benhartwich/Grabstein/gehaeuse/vorschau_3d.png

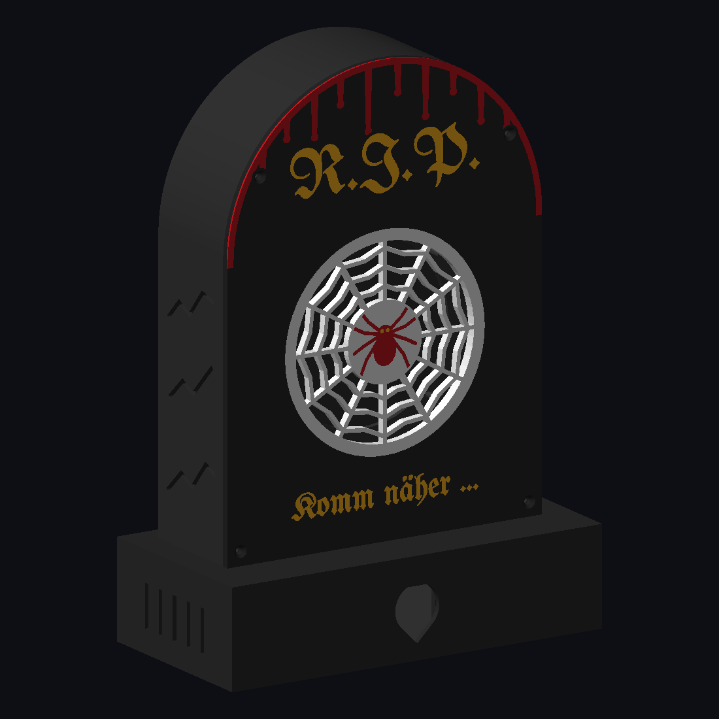
gehaeuse/vorschau_3d.png
