benhartwich/Grabstein/gehaeuse/vorschau_explosion.png

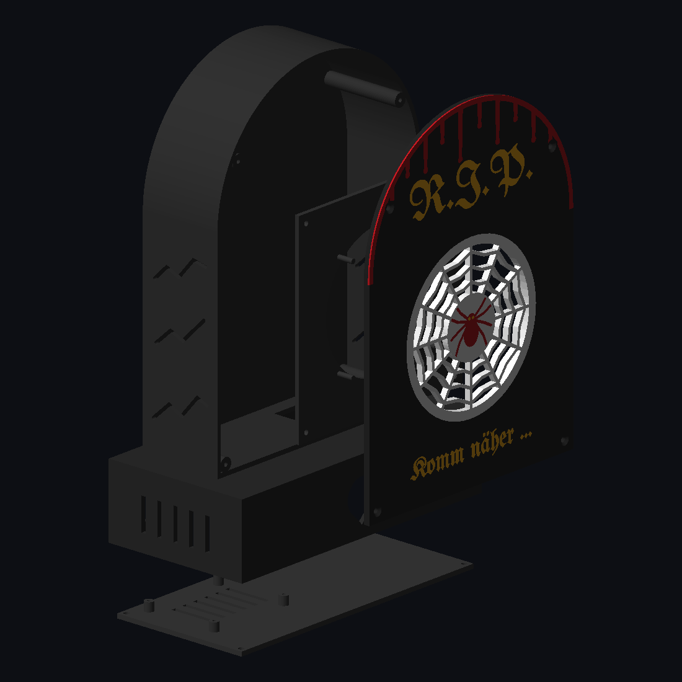
gehaeuse/vorschau_explosion.png
