benhartwich/Grabstein/gehaeuse/druck/Druck_5_Klemmdeckel_Regendach.3mf

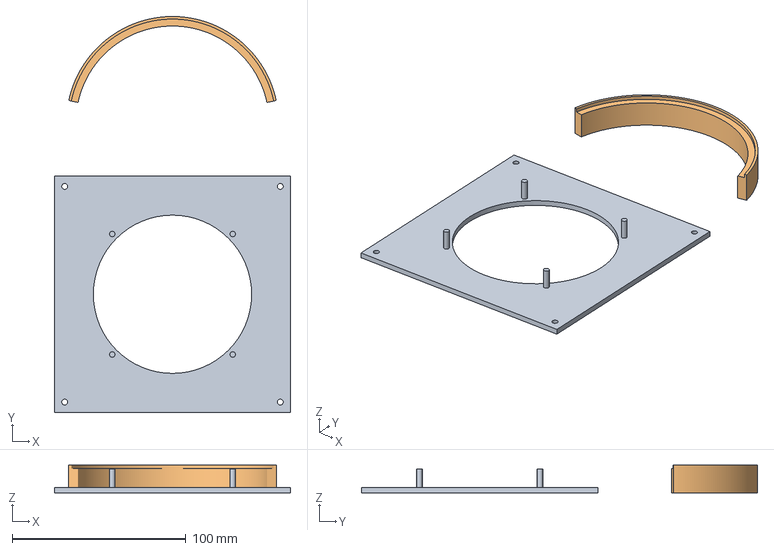
[picture p4: CAD file, 2026-10-17]
gehaeuse/druck/Druck_5_Klemmdeckel_Regendach.3mf
136.0 x 227.7 x 16.0 mm
Klemmdeckel
Regendach
