benhartwich/Grabstein/gehaeuse/stl/4_Bodenplatte_schwarz.stl

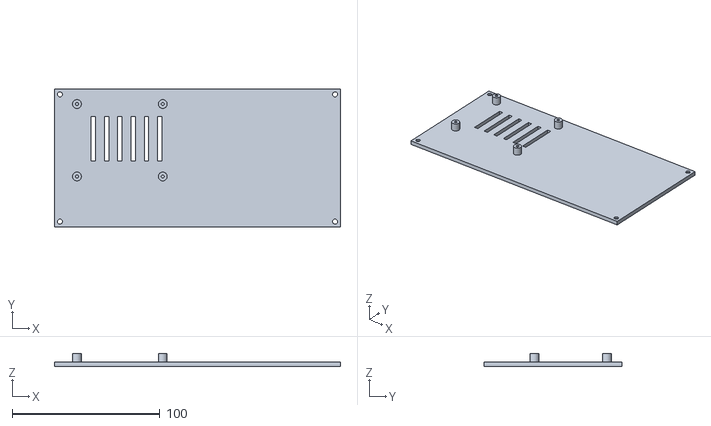
[picture p5: CAD file, 2026-10-16]
gehaeuse/stl/4_Bodenplatte_schwarz.stl
193.4 x 93.4 x 9.00
