benhartwich/Grabstein/gehaeuse/stl/6_Regendach_schwarz.stl

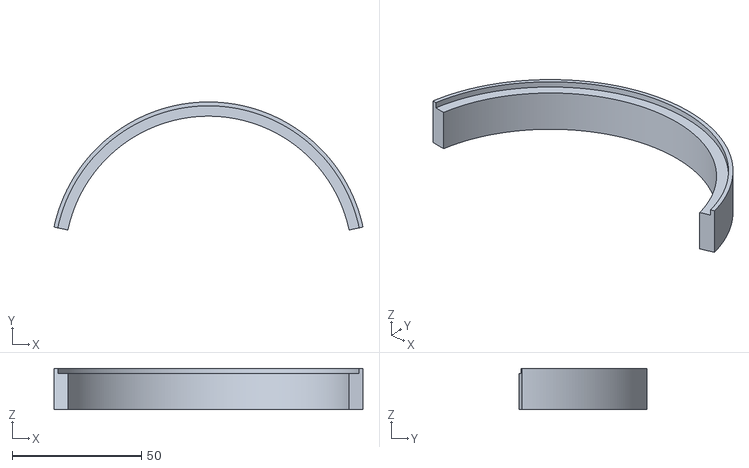
[picture p6: CAD file, 2026-10-16]
gehaeuse/stl/6_Regendach_schwarz.stl
119.3 x 49.5 x 16.0
