benhartwich/Grabstein/gehaeuse/druck/Druck_1_Frontplatte_4Farben.3mf

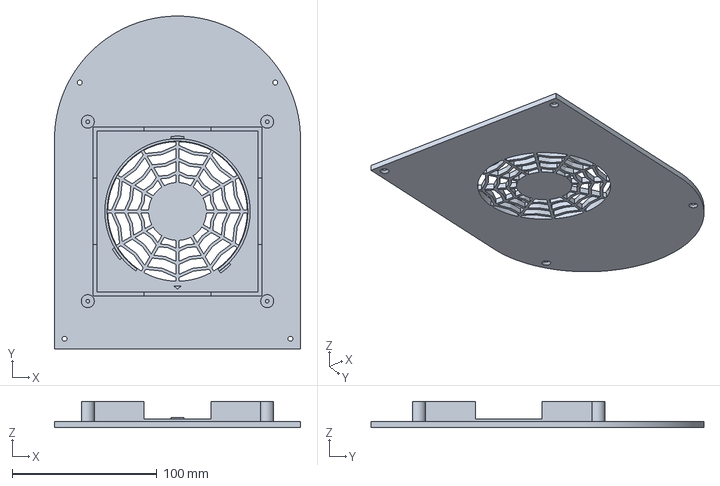
[picture p7: CAD file, 2026-10-16]
gehaeuse/druck/Druck_1_Frontplatte_4Farben.3mf
170.0 x 230.0 x 18.0 mm
