benhartwich/Grabstein/gehaeuse/stl/1_Frontplatte_B_weiss_Netz.stl

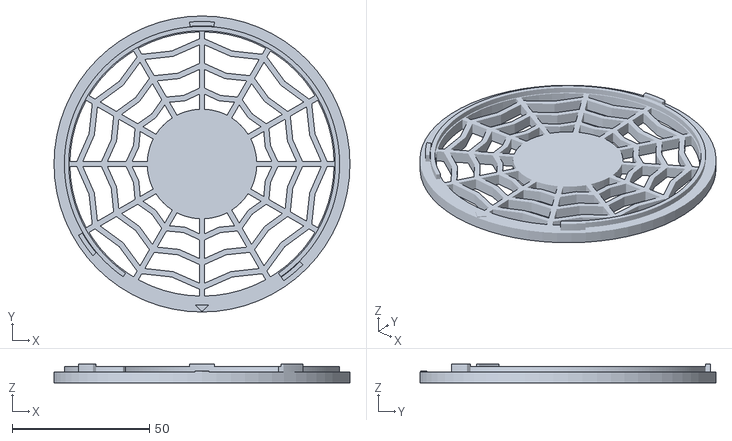
[picture p8: CAD file, 2026-10-16]
gehaeuse/stl/1_Frontplatte_B_weiss_Netz.stl
108.0 x 108.0 x 6.80
