benhartwich/Grabstein/gehaeuse/druck/Druck_2_Korpus.3mf

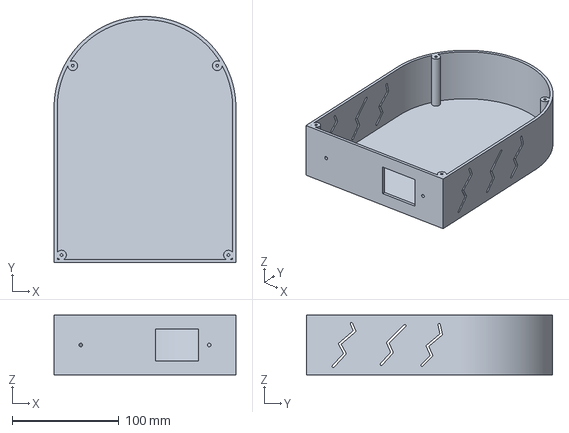
[picture p9: CAD file, 2026-10-16]
gehaeuse/druck/Druck_2_Korpus.3mf
170.0 x 230.0 x 56.0 mm
