benhartwich/Grabstein/gehaeuse/stl/1_Frontplatte_D_leucht_Schrift_Augen.stl

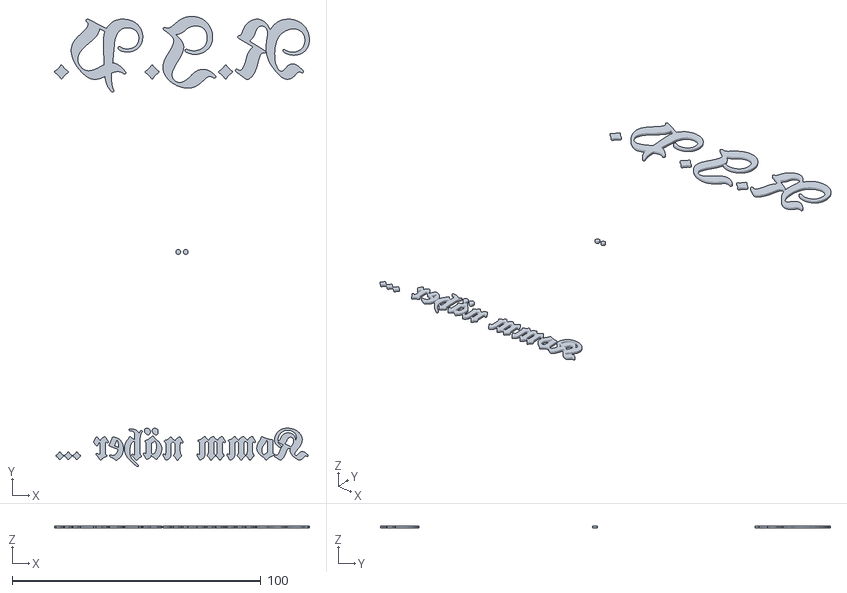
[picture p10: CAD file, 2026-10-16]
gehaeuse/stl/1_Frontplatte_D_leucht_Schrift_Augen.stl
102.5 x 181.0 x 1.00
