benhartwich/Grabstein/gehaeuse/druck/Druck_3_Sockel.3mf

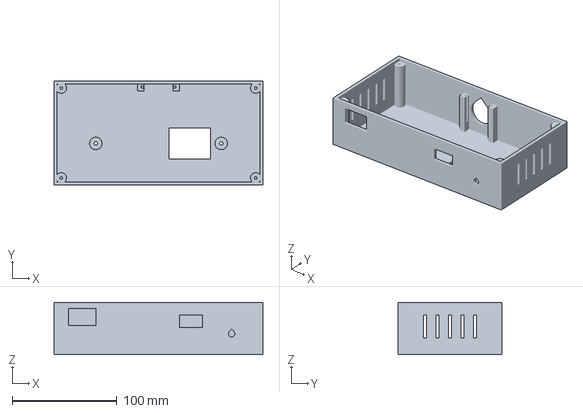
[picture p11: CAD file, 2026-10-16]
gehaeuse/druck/Druck_3_Sockel.3mf
200.0 x 100.0 x 50.0 mm
