benhartwich/Grabstein/gehaeuse/stl/5_Klemmdeckel_schwarz.stl

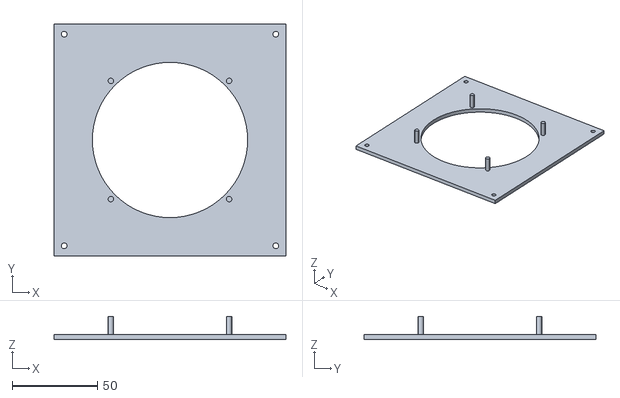
[picture p12: CAD file, 2026-10-16]
gehaeuse/stl/5_Klemmdeckel_schwarz.stl
136.0 x 136.0 x 13.7
