benhartwich/Grabstein/gehaeuse/stl/1_Frontplatte_A_schwarz.stl

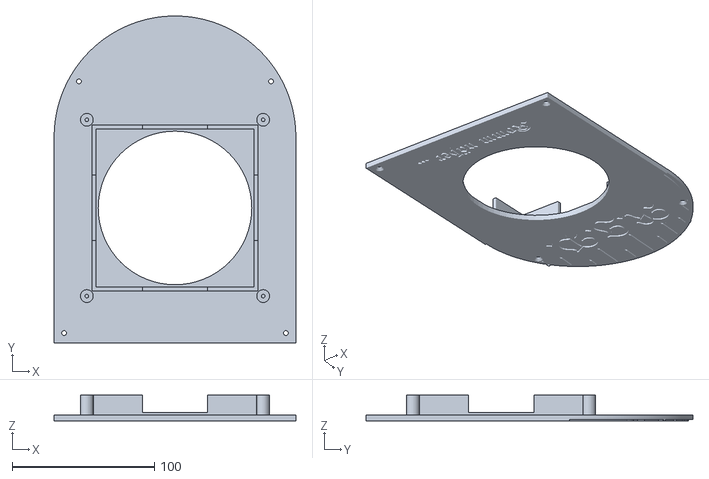
[picture p13: CAD file, 2026-10-16]
gehaeuse/stl/1_Frontplatte_A_schwarz.stl
170.0 x 230.0 x 18.0
