benhartwich/Grabstein/gehaeuse/stl/1_Frontplatte_C_rot_Blut_Spinne.stl

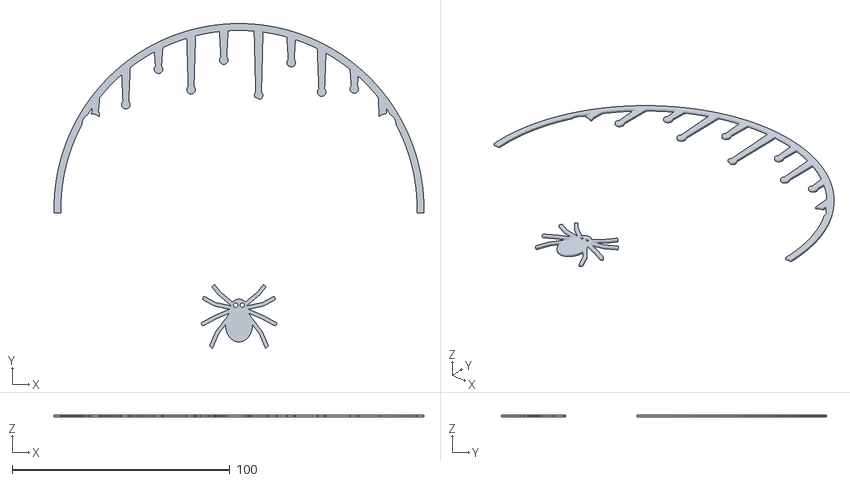
[picture p14: CAD file, 2026-10-16]
gehaeuse/stl/1_Frontplatte_C_rot_Blut_Spinne.stl
170.0 x 149.3 x 1.00
