benhartwich/Grabstein/(list of files, cad)

Other CAD files:
gehaeuse/druck/Druck_4_Bodenplatte.3mf
gehaeuse/stl/3_Sockel_schwarz.stl
gehaeuse/stl/2_Korpus_schwarz.stl
