benhartwich/Grabstein/docs/aufbau-bewegungsmelder.jpg

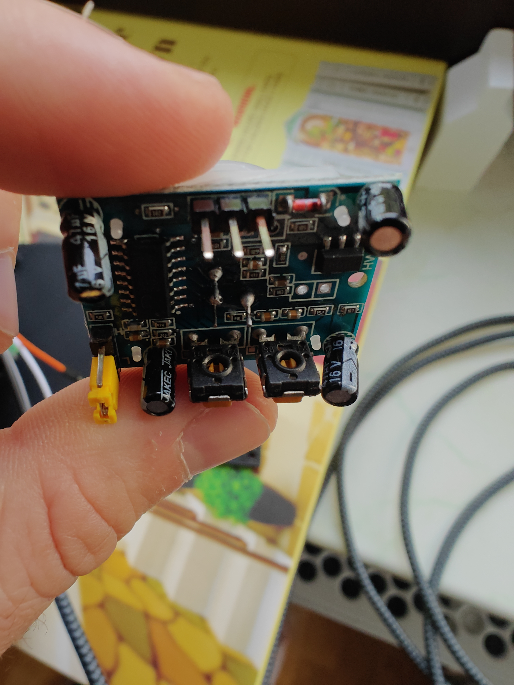
docs/aufbau-bewegungsmelder.jpg
