benhartwich/Grabstein/docs/aufbau-gpio-leiste.jpg

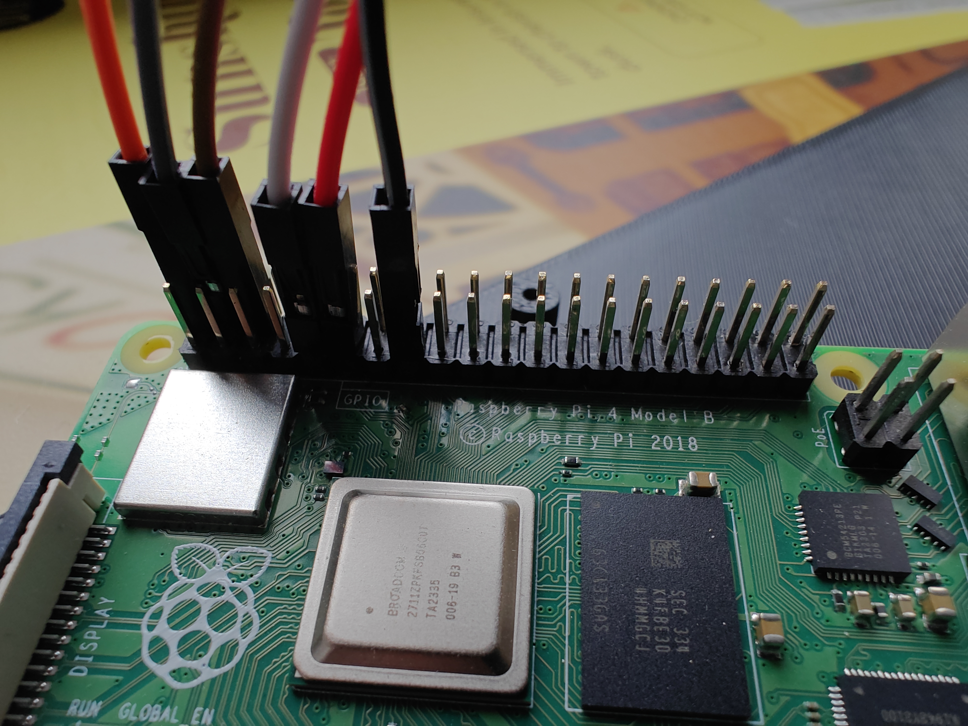
docs/aufbau-gpio-leiste.jpg
