benhartwich/Grabstein/docs/aufbau-pi-oben.jpg

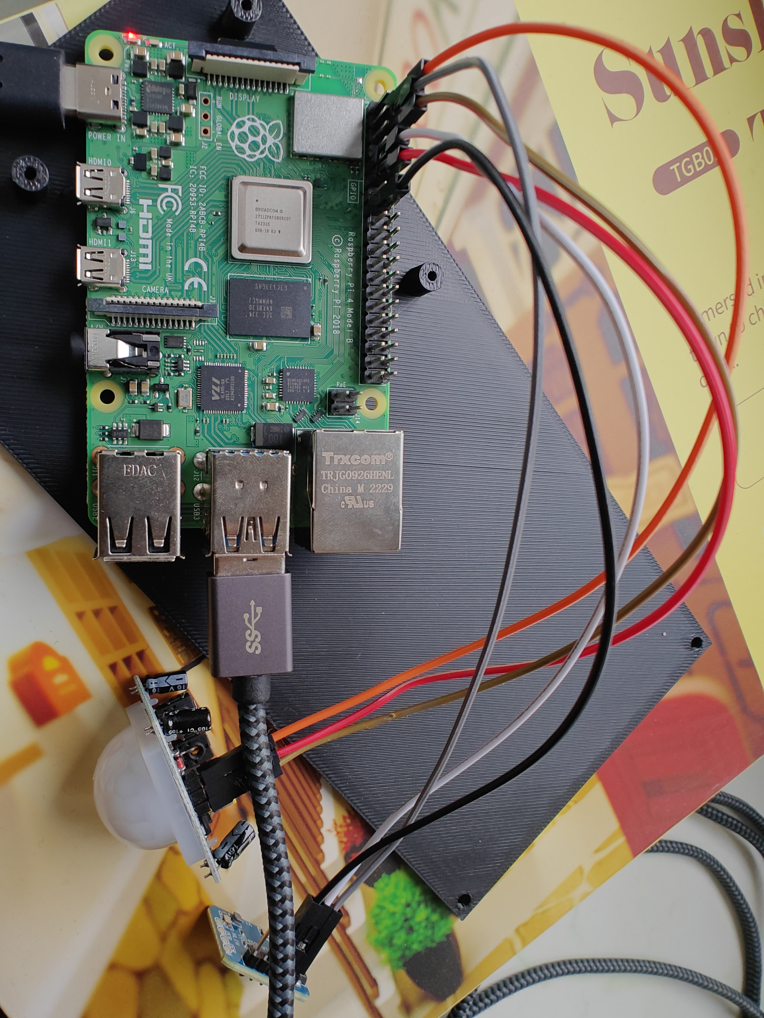
docs/aufbau-pi-oben.jpg
