benhartwich/Grabstein/docs/aufbau-radar-bauteilseite.jpg

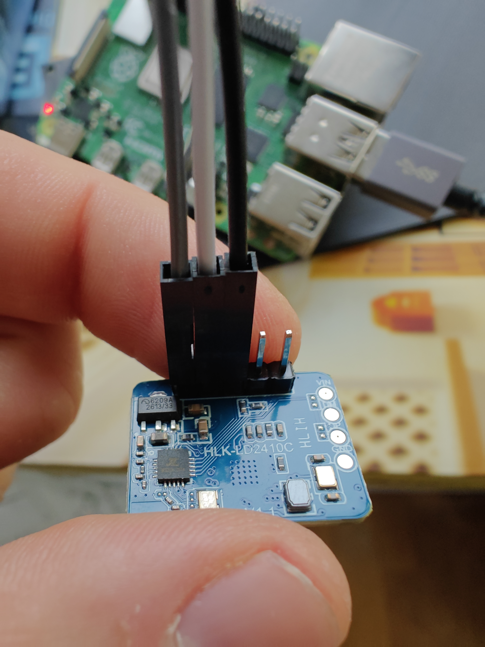
docs/aufbau-radar-bauteilseite.jpg
