benhartwich/Grabstein/docs/aufbau-radar.jpg

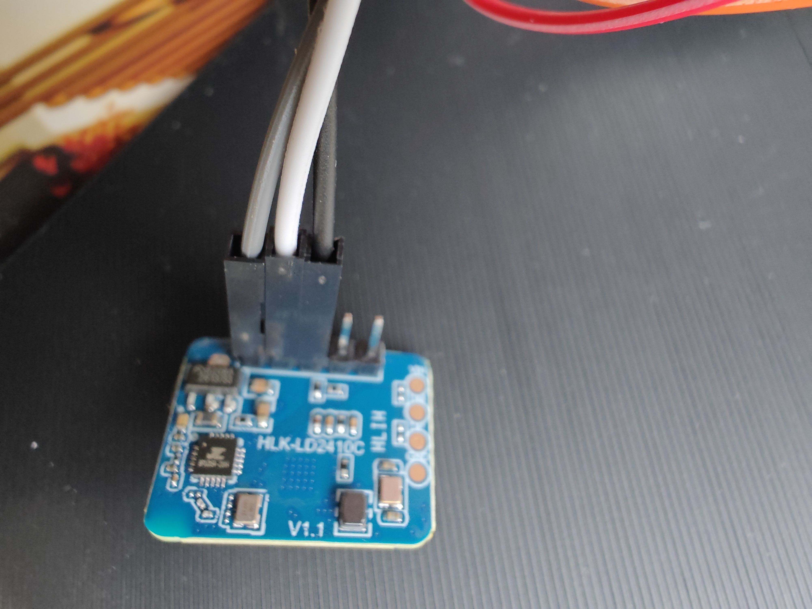
docs/aufbau-radar.jpg
