benhartwich/Grabstein/(commit log)

2026-10-16 Flüsternder Grabstein: Gehäuse, Pi-Software, Verkabelung
    Claude-Session: https://claude.ai/code/session_01KePzFUtdXcww5CumiCLbw3
    [1_Frontplatte_A_schwarz.stl, 1_Frontplatte_B_weiss_Netz.stl, 1_Frontplatte_C_rot_Blut_Spinne.stl, 1_Frontplatte_D_leucht_Schrift_Augen.stl, 2_Korpus_schwarz.stl, 3_Sockel_schwarz.stl, 4_Bodenplatte_schwarz.stl, 5_Klemmdeckel_schwarz.stl]
2026-10-16 Verkabelung: Aktivlautsprecher mit USB-Strom und Klinke
    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
2026-10-16 Verkabelung: passiver Lautsprecher an der JST-Buchse des ReSpeakers
    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
2026-10-17 CLAUDE.md: Kontext und offene Aufgaben für Claude Code auf dem Pi
    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
2026-10-17 install.sh: beschreibbares Arbeitsverzeichnis für lgpio
    Ohne WorkingDirectory läuft der Dienst in /, lgpio kann dort seine
    Notify-Datei nicht anlegen und gpiozero fällt auf den sysfs-Treiber
    zurück, der auf Kernel 6.18 mit EINVAL abbricht.
    Claude-Session: https://claude.ai/code/session_01X3qPP2WJps7P2mzNcSjk38
2026-10-17 Lautstärke 100, set_volume lässt Mikrofonregler in Ruhe
    set_volume setzte jeden Regler nach Namen, damit auch die Mikrofon-
    Verstärkung (Headset) auf die Wiedergabelautstärke, und erwischte den
    zweiten PCM-Regler nicht. Jetzt nur pvolume-Regler, mit Index.
    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
2026-10-17 Web-Oberfläche zum Steuern des Grabsteins
    - web.py + web/: JSON-API und responsive Oberfläche (Start, Zeitplan,
    Clips, Gustav, Mehr), läuft als Thread im Dienst auf Port 80
    - Einstellungen, Zeitplan und Betriebsart in /var/lib/grabstein,
    wirken ohne Neustart; Zeitplan mit Wochentags- und Datums-Einträgen
    - Clip-Katalog mit Bearbeiten, Erzeugen, Hochladen, An/Aus
    - Durchsage mit Gustavs Stimme, Zähler pro Abend
    - Gesprächs-Audio über arecord/aplay: PortAudio hing beim Stoppen, und
    das ReSpeaker-Mikrofon liefert nur bei laufender Wiedergabe (Stille-Strom)
    - Wrapper startet den Dienst nach Tests wieder; grabstein ton hängt nicht mehr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
2026-10-17 Testton leiser und kürzer (1 s, ca. -16 dB statt speaker-test)
    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
2026-10-17 Verkabelung: tatsächlicher Aufbau mit Kabelfarben, Lautsprecher-Einbau
    - verkabelung.html: neuer Abschnitt „So steckt es bei dir“ mit Ansichten
    wie auf den Fotos (Stiftleiste, Radar Bauteilseite, Bewegungsmelder),
    echte Kabelfarben in der Tabelle; Lautsprecher-Abschnitt aus der
    veröffentlichten Version übernommen
    - docs/: Fotos des Aufbaus und LD2410C-Pinbelegung aus dem Datenblatt
    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
2026-10-17 Verkabelung: Bewegungsmelder von der Bauteilseite, Drehregler-Hinweise
    Ansicht wie auf dem Foto (Kuppel hinten, Stifte oben): braun GND, rot OUT,
    orange VCC; VCC an Diode und Regler erkennbar. Fotos in docs/.
    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
2026-10-17 Gustav verabschiedet sich statt abzubrechen, Audio-Tags, neue Begrüßung
    - Am Zeitlimit oder bei leerem Budget bekommt Gustav "ZEIT UM" als
    Kontext-Hinweis, beantwortet das Letzte, verabschiedet sich und legt
    selbst auf; nach 30 s wird hart beendet (dann mit Abschieds-Clip)
    - Beim Auflegen durch Gustav wird die Verabschiedung noch ausgespielt
    - ElevenLabs-Höchstdauer = Limit + 45 s
    - Prompt: Geräusche als Audio-Tags ([giggles], [whispers] …) statt "kicher"
    - Erste Nachricht: "Als was bist du denn verkleidet?"
    - Audio-Leitungen beim Stoppen sauber schließen
    Claude-Session: https://claude.ai/code/session_01X3qPP2WJps7P2mzNcSjk3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
2026-10-17 install.sh: sudo-Regel für Dienststeuerung und Herunterfahren ohne Passwort
    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
2026-10-17 Gustav nicht unterbrechbar (client_events ohne interruption), Aufgabenliste
    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
2026-10-17 LED-Ring, Rätsel mit Codewort, Rätsel wird vor dem Abschied aufgelöst
    - Leds: ReSpeaker-Ring per USB (wie xvf_host.py) – aus im Ruhezustand,
    Atmen bei Clips, im Gespräch pulsiert Grün mit Gustavs Stimme
    - Einstellungen: leds (Schalter unter Mehr → Ton), codeword (Gustav)
    - Prompt: genau ein Rätsel, Codewort {{codewort}} als Belohnung, Lösung
    nach zwei Fehlversuchen bzw. spätestens bei ZEIT UM; häufiger [giggles]
    - install.sh: udev-Regel für den ReSpeaker, pyusb
    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
2026-10-17 Skript zum Freischalten von UART (Radar-Abstand) und SPI (LED-Streifen)
    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
2026-10-17 Verkabelung: Radar RX/TX an Pin 8/10, Ansichten-Generator im Repo
    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
2026-10-17 Radar-Abstand und Signalstärke per UART, Live-Anzeige in der Web-Oberfläche
    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
2026-10-17 Musik: Hintergrundmusik mit Ein-/Ausblenden (eigene Tracks, Web-Stream, Spotify), Tracks erzeugen
    - Music/MusicLibrary: mpg123 auf ALSA-Gerät musik (softvol vor dmix),
    Lautstärke blendet bei Clips ab und bei Gesprächen ganz aus
    - Web: Reiter Musik mit Quelle, Lautstärken, Stream-URL, Tracks,
    Hochladen und Erzeugen per ElevenLabs Music
    - musik-einrichten.sh + asound.conf.vorlage: Mischer systemweit, raspotify
    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
2026-10-17 Spotify: Anmeldung (PKCE), Playlist-Suche und automatisches Abspielen auf dem Gerät Grabstein
    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
2026-10-17 Betriebsart „Nur Musik“: Hintergrundmusik ohne Reaktion auf Sensoren, auch im Zeitplan
    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
2026-10-17 Veröffentlichung vorbereiten: README neu, Lizenzen (MIT + CC BY-NC-SA 4.0), Anleitungen aktualisiert
    - Druck_4 nur Bodenplatte, Druck_5 Klemmdeckel + Regendach (veralteter Klemmdeckel entfernt)
    - Datenblatt-Bild des Herstellers entfernt
    - persönliche Notizen aus CLAUDE.md nach CLAUDE.local.md (nicht im Repo)
    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
    [Druck_4_Bodenplatte.3mf, Druck_4_Bodenplatte_Klemmdeckel.3mf, Druck_5_Klemmdeckel_Regendach.3mf, Druck_5_Klemmdeckel_neu_Regendach.3mf]
2026-10-18 Hörbares Gesprächsende: Clips „Einschlafen“ und „Keine Antwort“, Gustav sagt beim Abschied, dass er wieder schläft; Budget 0 = ohne Limit
    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
    [grabstein.py]
2026-10-18 Schnellerer Gesprächsstart: signierte Adresse vorab holen, Aufwach-Clip überbrückt den Verbindungsaufbau
    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
2026-10-18 Gustav wartet geduldiger: fragt nach 8 s Stille nach, legt erst nach 25 s auf; kein „gell“ mehr; Stille zählt ab dem letzten Gesprochenen
    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
2026-10-18 Dazwischenreden wird mitgeschrieben statt verworfen (transcribe_on_disabled_interruptions)
    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
2026-10-18 Selbst-Mitschrift zurückgenommen; Gesprächspause endet, sobald alle weg sind; Pausen in der Live-Ansicht
    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
2026-10-18 Gustav führt das Gespräch: jede Antwort endet mit Frage, fester Ablauf Kostüm → Rätsel → Halloween-Frage → Abschied
    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
2026-10-23 Gustav: Abschied ausspielen, schneller zu Wort kommen, mehr Abwechslung
    - Ende: erst auflegen, wenn das letzte Audiostück wirklich gespielt ist (letztes Wort fehlte)
    - Mikrofon in 100-ms-Stücken statt 250 ms, speculative_turn an
    - Temperatur 0,8 statt 0; erste Nachricht mit kurzen Varianten (zufällig), 12 Rätsel per Zufallsnummer
    - Prompt: Fragen des Besuchs echt beantworten, Hintergrundgeschichte, kürzere Sätze, weniger Tags
    Claude-Session: https://claude.ai/code/session_01DKxXToaAn8JagxixD1zZqu
2026-10-29 Nach Zuruf-Clip: Gespräch schon nach 2 s Stehenbleiben, ohne Aufwach-Clip, kurze Begrüßung
    Die Leute antworten auf Vorbeigeh- und Lockruf-Clips sofort; Gustav bittet jetzt ums
    Wiederholen statt mit der langen Begrüßung anzufangen. Varianten im Web unter Gustav.
    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
2026-10-31 Abschied nicht mehr abgeschnitten: Pipe zu aplay auf 4 KB statt 64 KB
    Die Standard-Pipe puffert 2 s Ton. Gustav galt dadurch als fertig, während noch 2 s
    in der Pipe steckten, und beim Auflegen fielen genau die letzten Worte weg. Nebenbei
    hört man jede Antwort jetzt ~2 s früher.
    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
2026-10-31 Radar verliert stillstehende Besucher: kein Auflegen mitten im Gespräch, kein Sofort-Neustart
    - im Gespräch legt „niemand mehr da“ nur auf, wenn der Besuch auch 12 s nichts gesagt hat
    - dabei kein „Bist du noch da … wecken“-Clip mehr (der gehört nur zu „keine Antwort“)
    - neuer Besuch (Gesprächspause aufgehoben) erst nach 30 s ohne Radar statt 8 s
    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
